arun2201/MPI-Microwave-Oven-8085-/SQ1039_5V Dc Micro Linear Push Pull Solenoid.pdf

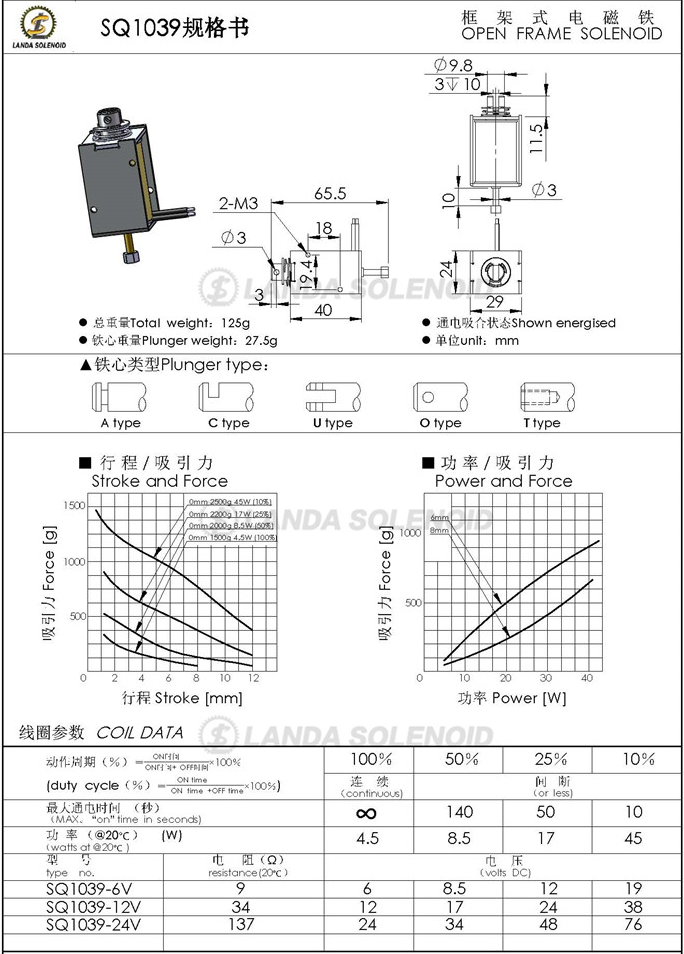
[picture p23: page 1]
