arun2201/MPI-Microwave-Oven-8085-/(list of files, drawings)

Other design files:
G2_Microwave.DSN
